Mm-Fazlollahpour/ESP32-NTC-Thermometer/README.md

# ESP32-Based NTC Thermometer
<p align="center">
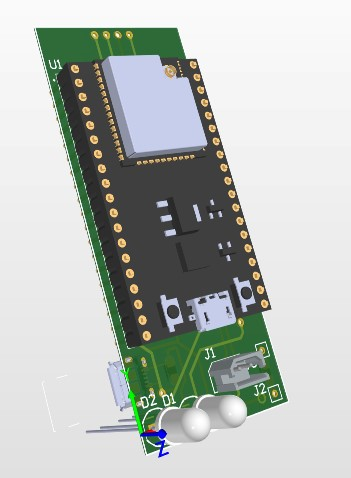
[picture p1: 3D.jpg]
3D view of ESP32-Based NTC Thermometer
  
</p>
<p align="center">
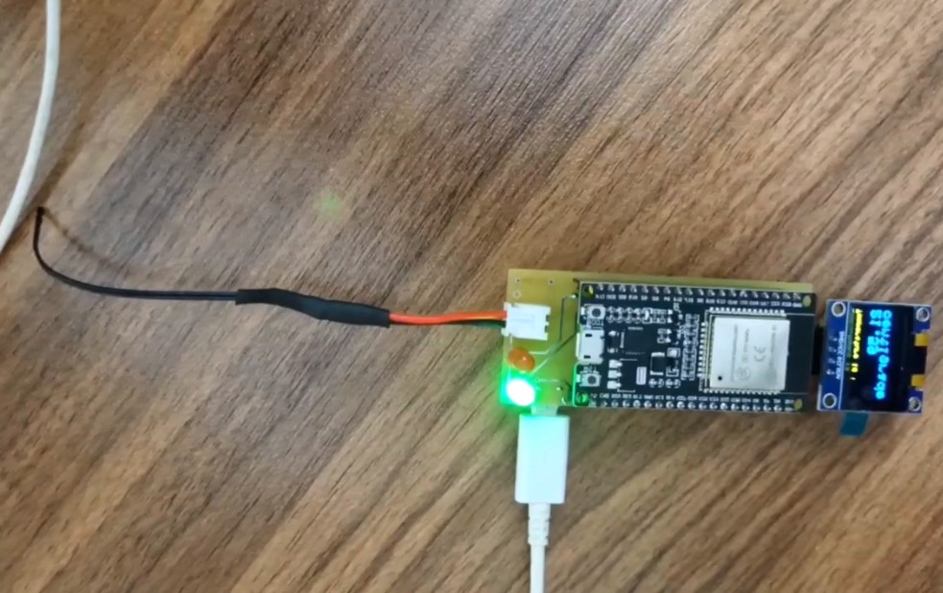
[picture p2: ESP32-NTC-Thermometer2.jpg]
ESP32-Based NTC Thermometer
  
</p>
<p align="center">
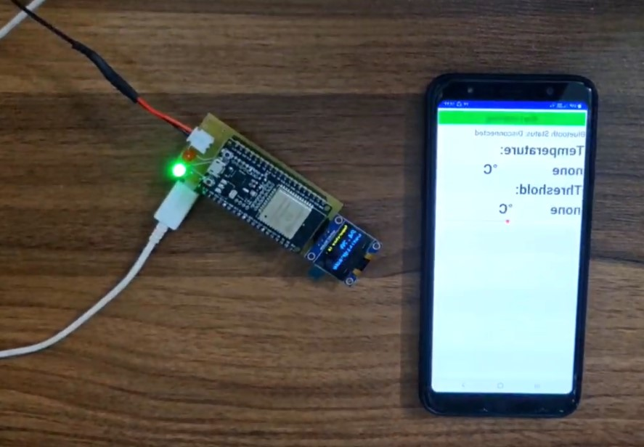
[picture p3: ESP32-NTC-Thermometer1.jpg]
ESP32-Based NTC Thermometer and Mobile Application
  
</p>

An ESP32-based NTC thermistor thermometer
featuring analog linearization, OLED temperature
display, Bluetooth Low Energy communication,
and configurable temperature threshold.
