Mm-Fazlollahpour/ESP32-NTC-Thermometer/Hardware/README.md

# Hardware Design

This directory contains the hardware design
documentation of the ESP32-based NTC thermometer.

The hardware design includes:

- NTC thermistor sensing circuit
- Analog signal conditioning
- Thermistor linearization network
- Voltage divider and buffer stage
- Circuit schematic
- Printed Circuit Board (PCB) layout
