Mm-Fazlollahpour/ESP32-NTC-Thermometer/Report/README.md

# Technical Report

This directory contains the complete technical
documentation of the ESP32-based NTC Thermometer
project, including its theoretical background,
hardware design, circuit analysis, and implementation.
