Mm-Fazlollahpour/ESP32-NTC-Thermometer/Demonstration/README.md

# Hardware Demonstration

This directory provides a demonstration
of the implemented ESP32-based NTC thermometer.

The demonstration covers:

- Real-time temperature measurement
- OLED temperature display
- Bluetooth Low Energy connectivity
- Mobile application interaction
- Temperature threshold adjustment
- LED status indication
