Mm-Fazlollahpour/ESP32-NTC-Thermometer/Firmware/README.md

# Firmware

This directory contains the ESP32 firmware
developed for the NTC-based temperature
measurement and monitoring system.

The firmware handles:
- Analog temperature acquisition
- Temperature calculation
- OLED display control
- Bluetooth Low Energy communication
- Configurable temperature threshold
- LED-based status indication
