Mm-Fazlollahpour/ESP32-NTC-Thermometer/Hardware/pcb.jpg

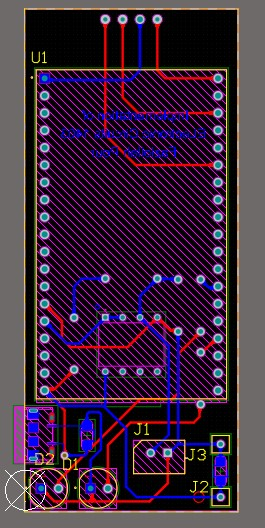
Hardware/pcb.jpg
