Mm-Fazlollahpour/ESP32-NTC-Thermometer/Hardware/schematic.jpg

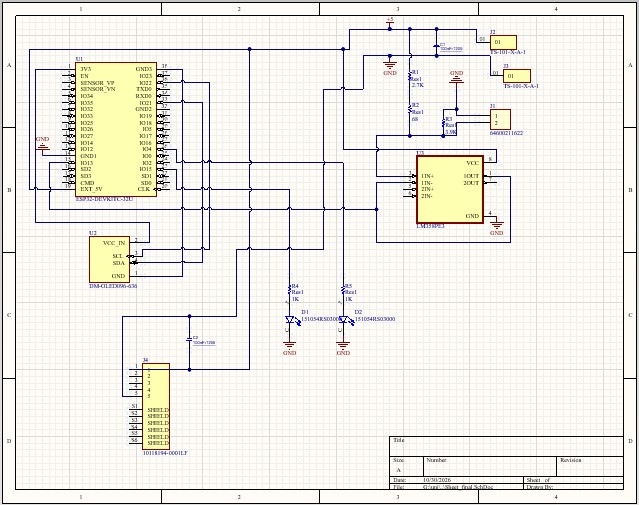
Hardware/schematic.jpg
