Mm-Fazlollahpour/ESP32-NTC-Thermometer/(list of files, drawings)

Other design files:
Hardware/PCB_final.PcbDoc
Hardware/Sheet_final.SchDoc
